GOROman/gowin-lm1881-clone/rtl/hdmi/font5x7.v

// 自動生成: tools/gen_font.py -- 5x7 フォント ROM
`default_nettype none
module font5x7(input wire [7:0] ch, input wire [2:0] row, output reg [4:0] bits);
    always @* begin
        case ({ch, row})
            {8'h20, 3'd0}: bits = 5'b00000; // ' '
            {8'h20, 3'd1}: bits = 5'b00000; // ' '
            {8'h20, 3'd2}: bits = 5'b00000; // ' '
            {8'h20, 3'd3}: bits = 5'b00000; // ' '
            {8'h20, 3'd4}: bits = 5'b00000; // ' '
            {8'h20, 3'd5}: bits = 5'b00000; // ' '
            {8'h20, 3'd6}: bits = 5'b00000; // ' '
            {8'h30, 3'd0}: bits = 5'b01110; // '0'
            {8'h30, 3'd1}: bits = 5'b10001; // '0'
            {8'h30, 3'd2}: bits = 5'b10011; // '0'
            {8'h30, 3'd3}: bits = 5'b10101; // '0'
            {8'h30, 3'd4}: bits = 5'b11001; // '0'
            {8'h30, 3'd5}: bits = 5'b10001; // '0'
            {8'h30, 3'd6}: bits = 5'b01110; // '0'
            {8'h31, 3'd0}: bits = 5'b00100; // '1'
            {8'h31, 3'd1}: bits = 5'b01100; // '1'
            {8'h31, 3'd2}: bits = 5'b00100; // '1'
            {8'h31, 3'd3}: bits = 5'b00100; // '1'
            {8'h31, 3'd4}: bits = 5'b00100; // '1'
            {8'h31, 3'd5}: bits = 5'b00100; // '1'
            {8'h31, 3'd6}: bits = 5'b01110; // '1'
            {8'h32, 3'd0}: bits = 5'b01110; // '2'
            {8'h32, 3'd1}: bits = 5'b10001; // '2'
            {8'h32, 3'd2}: bits = 5'b00001; // '2'
            {8'h32, 3'd3}: bits = 5'b00010; // '2'
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
            {8'h75, 3'd4}: bits = 5'b10001; // 'u'
            {8'h75, 3'd5}: bits = 5'b10011; // 'u'
            {8'h75, 3'd6}: bits = 5'b01101; // 'u'
            {8'h73, 3'd0}: bits = 5'b00000; // 's'
            {8'h73, 3'd1}: bits = 5'b00000; // 's'
            {8'h73, 3'd2}: bits = 5'b01111; // 's'
            {8'h73, 3'd3}: bits = 5'b10000; // 's'
            {8'h73, 3'd4}: bits = 5'b01110; // 's'
            {8'h73, 3'd5}: bits = 5'b00001; // 's'
            {8'h73, 3'd6}: bits = 5'b11110; // 's'
            default: bits = 5'b00000;
        endcase
    end
endmodule
`default_nettype wire
