GOROman/gowin-lm1881-clone/rtl/hdmi/screen_text.v

// 自動生成: tools/gen_screen.py -- 画面固定テキスト
`default_nettype none
module screen_text(input wire [5:0] col, input wire [4:0] row, output reg [7:0] ch);
    always @* begin
        ch = 8'h20;
        case (row)
            5'd0: case (col)
                6'd1: ch = 8'h4C; // 'L'
                6'd2: ch = 8'h4D; // 'M'
                6'd3: ch = 8'h31; // '1'
                6'd4: ch = 8'h38; // '8'
                6'd5: ch = 8'h38; // '8'
                6'd6: ch = 8'h31; // '1'
                6'd8: ch = 8'h43; // 'C'
                6'd9: ch = 8'h4C; // 'L'
                6'd10: ch = 8'h4F; // 'O'
                6'd11: ch = 8'h4E; // 'N'
                6'd12: ch = 8'h45; // 'E'
                6'd14: ch = 8'h2D; // '-'
                6'd16: ch = 8'h54; // 'T'
                6'd17: ch = 8'h41; // 'A'
                6'd18: ch = 8'h4E; // 'N'
                6'd19: ch = 8'h47; // 'G'
                6'd21: ch = 8'h4E; // 'N'
                6'd22: ch = 8'h41; // 'A'
                6'd23: ch = 8'h4E; // 'N'
                6'd24: ch = 8'h4F; // 'O'
                6'd26: ch = 8'h39; // '9'
                6'd27: ch = 8'h4B; // 'K'
                6'd30: ch = 8'h53; // 'S'
                6'd31: ch = 8'h59; // 'Y'
                6'd32: ch = 8'h4E; // 'N'
                6'd33: ch = 8'h43; // 'C'
                6'd35: ch = 8'h53; // 'S'
                6'd36: ch = 8'h45; // 'E'
                6'd37: ch = 8'h50; // 'P'
                default: ch = 8'h20;
            endcase
            5'd2: case (col)
                6'd1: ch = 8'h4C; // 'L'
                6'd2: ch = 8'h4F; // 'O'
                6'd3: ch = 8'h43; // 'C'
                6'd4: ch = 8'h4B; // 'K'
                6'd5: ch = 8'h3A; // ':'
                6'd6: ch = 8'h5B; // '['
                6'd8: ch = 8'h5D; // ']'
                6'd11: ch = 8'h50; // 'P'
                6'd12: ch = 8'h4C; // 'L'
                6'd13: ch = 8'h4C; // 'L'
                6'd14: ch = 8'h3A; // ':'
                6'd15: ch = 8'h5B; // '['
                6'd17: ch = 8'h5D; // ']'
                6'd20: ch = 8'h46; // 'F'
                6'd21: ch = 8'h49; // 'I'
                6'd22: ch = 8'h45; // 'E'
                6'd23: ch = 8'h4C; // 'L'
                6'd24: ch = 8'h44; // 'D'
                6'd25: ch = 8'h3A; // ':'
                6'd26: ch = 8'h2D; // '-'
                6'd27: ch = 8'h2D; // '-'
                6'd28: ch = 8'h2D; // '-'
                6'd32: ch = 8'h49; // 'I'
                6'd33: ch = 8'h4E; // 'N'
                6'd34: ch = 8'h3A; // ':'
                6'd35: ch = 8'h5B; // '['
                6'd37: ch = 8'h5D; // ']'
                default: ch = 8'h20;
            endcase
            5'd4: case (col)
                6'd1: ch = 8'h4C; // 'L'
                6'd2: ch = 8'h49; // 'I'
                6'd3: ch = 8'h4E; // 'N'
                6'd4: ch = 8'h45; // 'E'
                6'd5: ch = 8'h53; // 'S'
                6'd6: ch = 8'h2F; // '/'
                6'd7: ch = 8'h46; // 'F'
                6'd8: ch = 8'h49; // 'I'
                6'd9: ch = 8'h45; // 'E'
                6'd10: ch = 8'h4C; // 'L'
                6'd11: ch = 8'h44; // 'D'
                6'd12: ch = 8'h3A; // ':'
                6'd13: ch = 8'h2D; // '-'
                6'd14: ch = 8'h2D; // '-'
                6'd15: ch = 8'h2D; // '-'
                6'd18: ch = 8'h48; // 'H'
                6'd19: ch = 8'h3A; // ':'
                6'd20: ch = 8'h2D; // '-'
                6'd21: ch = 8'h2D; // '-'
                6'd22: ch = 8'h2E; // '.'
                6'd23: ch = 8'h2D; // '-'
                6'd24: ch = 8'h75; // 'u'
                6'd25: ch = 8'h73; // 's'
                6'd28: ch = 8'h53; // 'S'
                6'd29: ch = 8'h59; // 'Y'
                6'd30: ch = 8'h4E; // 'N'
                6'd31: ch = 8'h43; // 'C'
                6'd32: ch = 8'h3A; // ':'
                6'd33: ch = 8'h2D; // '-'
                6'd34: ch = 8'h2E; // '.'
                6'd35: ch = 8'h2D; // '-'
                6'd36: ch = 8'h75; // 'u'
                6'd37: ch = 8'h73; // 's'
                default: ch = 8'h20;
            endcase
            5'd5: case (col)
                6'd1: ch = 8'h53; // 'S'
                6'd2: ch = 8'h4C; // 'L'
                6'd3: ch = 8'h49; // 'I'
                6'd4: ch = 8'h43; // 'C'
                6'd5: ch = 8'h45; // 'E'
                6'd7: ch = 8'h44; // 'D'
                6'd8: ch = 8'h55; // 'U'
                6'd9: ch = 8'h54; // 'T'
                6'd10: ch = 8'h59; // 'Y'
                6'd11: ch = 8'h3A; // ':'
                6'd12: ch = 8'h2D; // '-'
                6'd13: ch = 8'h2D; // '-'
                6'd14: ch = 8'h2D; // '-'
                6'd15: ch = 8'h2F; // '/'
                6'd16: ch = 8'h32; // '2'
                6'd17: ch = 8'h35; // '5'
                6'd18: ch = 8'h35; // '5'
                6'd21: ch = 8'h28; // '('
                6'd22: ch = 8'h53; // 'S'
                6'd23: ch = 8'h31; // '1'
                6'd24: ch = 8'h3A; // ':'
                6'd25: ch = 8'h48; // 'H'
                6'd26: ch = 8'h4F; // 'O'
                6'd27: ch = 8'h4C; // 'L'
                6'd28: ch = 8'h44; // 'D'
                6'd30: ch = 8'h53; // 'S'
                6'd31: ch = 8'h32; // '2'
                6'd32: ch = 8'h3A; // ':'
                6'd33: ch = 8'h52; // 'R'
                6'd34: ch = 8'h53; // 'S'
                6'd35: ch = 8'h54; // 'T'
                6'd36: ch = 8'h29; // ')'
                default: ch = 8'h20;
            endcase
            5'd7: case (col)
                6'd1: ch = 8'h48; // 'H'
                6'd3: ch = 8'h56; // 'V'
                6'd4: ch = 8'h49; // 'I'
                6'd5: ch = 8'h45; // 'E'
                6'd6: ch = 8'h57; // 'W'
                6'd7: ch = 8'h3A; // ':'
                6'd9: ch = 8'h31; // '1'
                6'd11: ch = 8'h4C; // 'L'
                6'd12: ch = 8'h49; // 'I'
                6'd13: ch = 8'h4E; // 'N'
                6'd14: ch = 8'h45; // 'E'
                6'd16: ch = 8'h3D; // '='
                6'd18: ch = 8'h37; // '7'
                6'd19: ch = 8'h36; // '6'
                6'd20: ch = 8'h75; // 'u'
                6'd21: ch = 8'h73; // 's'
                6'd24: ch = 8'h54; // 'T'
                6'd25: ch = 8'h52; // 'R'
                6'd26: ch = 8'h49; // 'I'
                6'd27: ch = 8'h47; // 'G'
                6'd28: ch = 8'h3D; // '='
                6'd29: ch = 8'h48; // 'H'
                6'd30: ch = 8'h53; // 'S'
                6'd31: ch = 8'h59; // 'Y'
                6'd32: ch = 8'h4E; // 'N'
                6'd33: ch = 8'h43; // 'C'
                default: ch = 8'h20;
            endcase
            5'd8: case (col)
                6'd0: ch = 8'h43; // 'C'
                6'd1: ch = 8'h53; // 'S'
                default: ch = 8'h20;
            endcase
            5'd10: case (col)
                6'd0: ch = 8'h48; // 'H'
                6'd1: ch = 8'h53; // 'S'
                default: ch = 8'h20;
            endcase
            5'd12: case (col)
                6'd0: ch = 8'h56; // 'V'
                6'd1: ch = 8'h53; // 'S'
                default: ch = 8'h20;
            endcase
            5'd14: case (col)
                6'd0: ch = 8'h42; // 'B'
                6'd1: ch = 8'h47; // 'G'
                default: ch = 8'h20;
            endcase
            5'd16: case (col)
                6'd1: ch = 8'h56; // 'V'
                6'd3: ch = 8'h56; // 'V'
                6'd4: ch = 8'h49; // 'I'
                6'd5: ch = 8'h45; // 'E'
                6'd6: ch = 8'h57; // 'W'
                6'd7: ch = 8'h3A; // ':'
                6'd9: ch = 8'h36; // '6'
                6'd10: ch = 8'h2E; // '.'
                6'd11: ch = 8'h34; // '4'
                6'd13: ch = 8'h4C; // 'L'
                6'd14: ch = 8'h49; // 'I'
                6'd15: ch = 8'h4E; // 'N'
                6'd16: ch = 8'h45; // 'E'
                6'd17: ch = 8'h53; // 'S'
                6'd19: ch = 8'h3D; // '='
                6'd21: ch = 8'h34; // '4'
                6'd22: ch = 8'h30; // '0'
                6'd23: ch = 8'h36; // '6'
                6'd24: ch = 8'h75; // 'u'
                6'd25: ch = 8'h73; // 's'
                6'd28: ch = 8'h54; // 'T'
                6'd29: ch = 8'h52; // 'R'
                6'd30: ch = 8'h49; // 'I'
                6'd31: ch = 8'h47; // 'G'
                6'd32: ch = 8'h3D; // '='
                6'd33: ch = 8'h56; // 'V'
                6'd34: ch = 8'h53; // 'S'
                6'd35: ch = 8'h59; // 'Y'
                6'd36: ch = 8'h4E; // 'N'
                6'd37: ch = 8'h43; // 'C'
                default: ch = 8'h20;
            endcase
            5'd17: case (col)
                6'd0: ch = 8'h43; // 'C'
                6'd1: ch = 8'h53; // 'S'
                default: ch = 8'h20;
            endcase
            5'd19: case (col)
                6'd0: ch = 8'h48; // 'H'
                6'd1: ch = 8'h53; // 'S'
                default: ch = 8'h20;
            endcase
            5'd21: case (col)
                6'd0: ch = 8'h56; // 'V'
                6'd1: ch = 8'h53; // 'S'
                default: ch = 8'h20;
            endcase
            5'd23: case (col)
                6'd0: ch = 8'h42; // 'B'
                6'd1: ch = 8'h47; // 'G'
                default: ch = 8'h20;
            endcase
            5'd26: case (col)
                6'd1: ch = 8'h4F; // 'O'
                6'd2: ch = 8'h55; // 'U'
                6'd3: ch = 8'h54; // 'T'
                6'd5: ch = 8'h32; // '2'
                6'd6: ch = 8'h37; // '7'
                6'd7: ch = 8'h3D; // '='
                6'd8: ch = 8'h43; // 'C'
                6'd9: ch = 8'h53; // 'S'
                6'd11: ch = 8'h32; // '2'
                6'd12: ch = 8'h38; // '8'
                6'd13: ch = 8'h3D; // '='
                6'd14: ch = 8'h48; // 'H'
                6'd15: ch = 8'h53; // 'S'
                6'd17: ch = 8'h32; // '2'
                6'd18: ch = 8'h39; // '9'
                6'd19: ch = 8'h3D; // '='
                6'd20: ch = 8'h56; // 'V'
                6'd21: ch = 8'h53; // 'S'
                6'd23: ch = 8'h33; // '3'
                6'd24: ch = 8'h30; // '0'
                6'd25: ch = 8'h3D; // '='
                6'd26: ch = 8'h42; // 'B'
                6'd27: ch = 8'h47; // 'G'
                6'd29: ch = 8'h33; // '3'
                6'd30: ch = 8'h31; // '1'
                6'd31: ch = 8'h3D; // '='
                6'd32: ch = 8'h4F; // 'O'
                6'd33: ch = 8'h45; // 'E'
                6'd35: ch = 8'h33; // '3'
                6'd36: ch = 8'h32; // '2'
                6'd37: ch = 8'h3D; // '='
                6'd38: ch = 8'h4C; // 'L'
                6'd39: ch = 8'h4B; // 'K'
                default: ch = 8'h20;
            endcase
            5'd28: case (col)
                6'd1: ch = 8'h47; // 'G'
                6'd2: ch = 8'h49; // 'I'
                6'd3: ch = 8'h54; // 'T'
                6'd4: ch = 8'h48; // 'H'
                6'd5: ch = 8'h55; // 'U'
                6'd6: ch = 8'h42; // 'B'
                6'd7: ch = 8'h2E; // '.'
                6'd8: ch = 8'h43; // 'C'
                6'd9: ch = 8'h4F; // 'O'
                6'd10: ch = 8'h4D; // 'M'
                6'd11: ch = 8'h2F; // '/'
                6'd12: ch = 8'h47; // 'G'
                6'd13: ch = 8'h4F; // 'O'
                6'd14: ch = 8'h52; // 'R'
                6'd15: ch = 8'h4F; // 'O'
                6'd16: ch = 8'h4D; // 'M'
                6'd17: ch = 8'h41; // 'A'
                6'd18: ch = 8'h4E; // 'N'
                6'd19: ch = 8'h2F; // '/'
                6'd20: ch = 8'h47; // 'G'
                6'd21: ch = 8'h4F; // 'O'
                6'd22: ch = 8'h57; // 'W'
                6'd23: ch = 8'h49; // 'I'
                6'd24: ch = 8'h4E; // 'N'
                6'd25: ch = 8'h2D; // '-'
                6'd26: ch = 8'h4C; // 'L'
                6'd27: ch = 8'h4D; // 'M'
                6'd28: ch = 8'h31; // '1'
                6'd29: ch = 8'h38; // '8'
                6'd30: ch = 8'h38; // '8'
                6'd31: ch = 8'h31; // '1'
                6'd32: ch = 8'h2D; // '-'
                6'd33: ch = 8'h43; // 'C'
                6'd34: ch = 8'h4C; // 'L'
                6'd35: ch = 8'h4F; // 'O'
                6'd36: ch = 8'h4E; // 'N'
                6'd37: ch = 8'h45; // 'E'
                default: ch = 8'h20;
            endcase
            default: ch = 8'h20;
        endcase
    end
endmodule
`default_nettype wire
