GOROman/gowin-lm1881-clone/(commit log)

2026-09-04 STEP 0: リポジトリ作成と作業計画 (README)
    Claude-Session: https://claude.ai/code/session_01JphVJVZkpCzDMaK1rdw4M5
2026-09-04 STEP 1: LM1881風 sync_separator コアRTL と NTSC 模擬テストベンチ (PASS)
    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
2026-09-04 STEP 2: Tang Nano 9K トップ (PLL/CLKDIV, スライスレベル AGC PWM, LED) と制約、gw_sh ビルド
    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
2026-09-04 STEP 3: HDMI ステータス表示 (TMDS/OSER10, 5x7 フォント, 同期波形オシロ表示, シミュレーション画面ダンプ)
    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
2026-09-04 STEP 4: 書き込み手順・使い方・CI (iverilog シミュレーション) を整備
    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
2026-09-04 sim: ELVDS_OBUF スタブ追加 (CI 修正)
    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
    [gowin_stubs.v]
2026-09-04 docs: 使い方とコンポジット信号の入れ方 (フロントエンド回路・起動手順・画面の見方・トラブルシュート)
    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
2026-09-04 sim: PAL (625本) テスト追加、README に検証状況と Release 案内を追記
    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
2026-09-04 bitstream: Tang Nano 9K 用ビルド済み lm1881_clone.fs を同梱
    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
